Albert2009Zi/Power_Supply_Control_PIC12F675/01_Documents/On breadboard programming/PinoutBB2.jpg

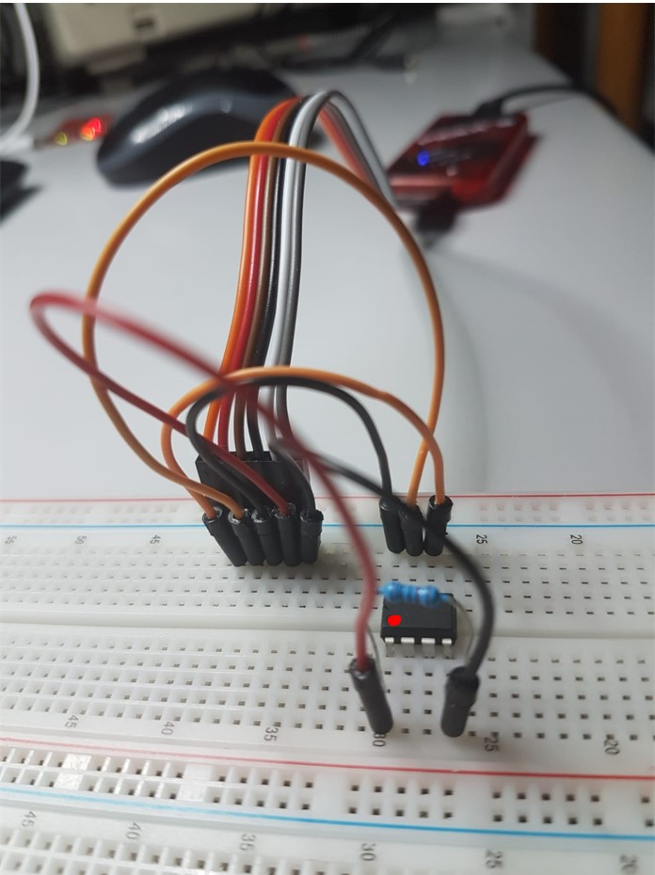
01_Documents/On breadboard programming/PinoutBB2.jpg
