Albert2009Zi/Power_Supply_Control_PIC12F675/01_Documents/Schematic1 Picture.jpg

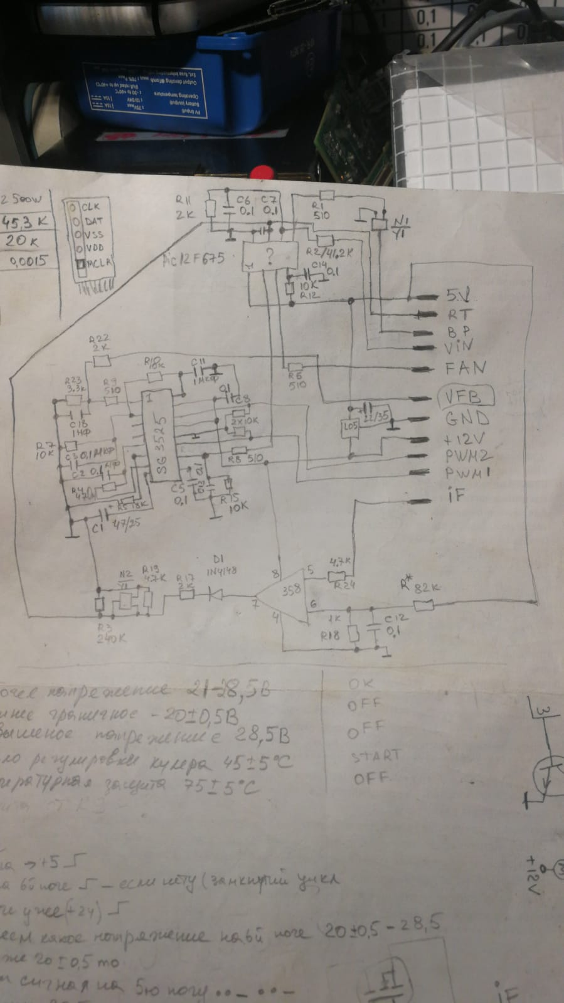
01_Documents/Schematic1 Picture.jpg
