Albert2009Zi/Power_Supply_Control_PIC12F675/04_Schematic/PIC12F675_prt_V2/Prototype.html

Altium customize

# Board Information Report

Date: | | 05.05.2024
Time: | | 17:31:00
Elapsed Time: | | 00:00:01
Filename: | | C:\dev\PCB Design\Altium\Projects\PIC12F675_prt\Prototype.PcbDoc
Units: | | mmmils

## Contents

Contents

Board Specification

General

Routing

Routing Information

Layer Information

Layer Information

Drill Pairs

Copper Area

Copper Area

Board Holes

Non-Plated Hole Size

Plated Hole Size

Board Slots

Non-Plated Slot Size

Plated Slot Size

Board Square Holes

Non-Plated Square Hole Size

Plated Square Hole Size

Other

Top Layer Annular Ring Size

Mid Layer Annular Ring Size

Bottom Layer Annular Ring Size

Pad Solder Mask

Pad Paste Mask

Pad Pwr/Gnd Expansion

Pad Relief Conductor Width

Pad Relief Air Gap

Pad Relief Entries

Via Solder Mask

Via Pwr/Gnd Expansion

Track Width

Arc Line Width

Arc Radius

Arc Degrees

Text Height

Text Width

Net Track Width

Net Via Size

## Board Specification

General
Board Size | 52.5mm x 57.5mm
Components on board | 31

Back to top

## Routing

Routing Information
Routing completion | 94,83%
Connections | 58
Connections routed | 55
Connections remaining | 3

Back to top

## Layer Information

Layer | Arcs | Pads | Vias | Tracks | Texts | Fills | Regions | ComponentBodies
Top Layer | 0 | 60 | 0 | 152 | 0 | 0 | 0 | 0
Bottom Layer | 0 | 3 | 0 | 17 | 0 | 0 | 1 | 0
Mechanical 1 | 0 | 0 | 0 | 1 | 0 | 0 | 0 | 30
Mechanical 13 | 3 | 0 | 0 | 129 | 0 | 0 | 0 | 1
Mechanical 15 | 0 | 0 | 0 | 122 | 0 | 0 | 0 | 0
Multi-Layer | 0 | 19 | 22 | 0 | 0 | 0 | 1 | 0
Top Paste | 0 | 0 | 0 | 0 | 0 | 0 | 0 | 0
Top Overlay | 24 | 0 | 0 | 57 | 60 | 0 | 0 | 0
Top Solder | 0 | 0 | 0 | 0 | 0 | 0 | 0 | 0
Bottom Solder | 0 | 0 | 0 | 0 | 0 | 0 | 0 | 0
Bottom Overlay | 2 | 0 | 0 | 4 | 2 | 0 | 0 | 0
Bottom Paste | 0 | 0 | 0 | 0 | 0 | 0 | 0 | 0
Drill Guide | 0 | 0 | 0 | 0 | 0 | 0 | 0 | 0
Keep-Out Layer | 0 | 0 | 0 | 0 | 0 | 0 | 0 | 0
Drill Drawing | 0 | 0 | 0 | 0 | 0 | 0 | 0 | 0
Total | 29 | 82 | 22 | 482 | 62 | 0 | 2 | 31

Back to top

Drill Pairs | Vias
Top Layer - Bottom Layer | 22
Total | 22

Back to top

## Copper Area

Layer | Sq.In. | Sq.MM. | Percent of layer
Top Layer | 0,512 | 330,623 | 11%
Bottom Layer | 4,516 | 2913,522 | 97%
Total | NaN | NaN

Back to top

## Board Holes

Non-Plated Hole Size | Pads | Vias
0mm | 63 | 0
1.2mm | 2 | 0
Total | 65 | 0

Back to top

Plated Hole Size | Pads | Vias
0.7mm | 2 | 0
0.7112mm | 0 | 22
0.9mm | 8 | 0
1.1mm | 2 | 0
1.15mm | 5 | 0
Total | 17 | 22

Back to top

## Board Slots

Non-Plated Slot Size / Length | Pads
Total | 0

Back to top

Plated Slot Size / Length | Pads
Total | 0

Back to top

## Board Square Holes

Non-Plated Square Hole Size | Pads
Total | 0

Back to top

Plated Square Hole Size | Pads
Total | 0

Back to top

## Other

Top Layer Annular Ring Size | Count
-0.6mm | 2
0.5mm | 2
0.55mm | 2
0.5588mm | 22
0.575mm | 5
0.6mm | 8
Total | 41

Back to top

Mid Layer Annular Ring Size | Count
-0.6mm | 2
0.5mm | 2
0.55mm | 2
0.5588mm | 22
0.575mm | 5
0.6mm | 8
Total | 41

Back to top

Bottom Layer Annular Ring Size | Count
-0.6mm | 2
0.5mm | 2
0.55mm | 2
0.5588mm | 22
0.575mm | 5
0.6mm | 8
Total | 41

Back to top

Pad Solder Mask | Count
0.1016mm | 82
Total | 82

Back to top

Pad Paste Mask | Count
0mm | 82
Total | 82

Back to top

Pad Pwr/Gnd Expansion | Count
0.508mm | 82
Total | 82

Back to top

Pad Relief Conductor Width | Count
0.254mm | 82
Total | 82

Back to top

Pad Relief Air Gap | Count
0.254mm | 82
Total | 82

Back to top

Pad Relief Entries | Count
4 | 82
Total | 82

Back to top

Via Solder Mask | Count
0.1016mm | 22
Total | 22

Back to top

Via Pwr/Gnd Expansion | Count
0.508mm | 22
Total | 22

Back to top

Track Width | Count
0.05mm | 84
0.1mm | 155
0.2mm | 65
0.254mm | 86
0.8mm | 92
Total | 482

Back to top

Arc Line Width | Count
0.0861mm | 2
0.1mm | 13
0.2mm | 12
0.25mm | 1
0.6mm | 1
Total | 29

Back to top

Arc Radius | Count
0.043mm | 2
0.05mm | 19
0.125mm | 1
0.3mm | 1
0.5mm | 1
0.635mm | 1
6.3mm | 4
Total | 29

Back to top

Arc Degrees | Count
180 | 26
360 | 3
Total | 29

Back to top

Text Height | Count
1.524mm | 62
Total | 62

Back to top

Text Width | Count
0.254mm | 62
Total | 62

Back to top

Net Track Width | Count
0.1mm | 17
Total | 17

Back to top

Net Via Size | Count
1.27mm | 17
Total | 17

Back to top
