Albert2009Zi/Power_Supply_Control_PIC12F675/01_Documents/On breadboard programming/Readme.txt

EN: This short photo guide is for my friend and co-author of this project, Alex Talko,
    who is working remotely on the hardware part.
    The guide shows how to connect and prepare the PIC12F625 microcontroller for programming
    using a Chinese clone of the PICkit3 debugger on a breadboard.
DE: Diese kurze Fotoanleitung ist für meinen Freund und Co-Autor dieses Projekts, Alex Talko, gemacht.
    Er arbeitet an diesem Projekt remote an der Hardware.
    Die Anleitung zeigt die Verbindung und Vorbereitung des PIC12F625-Mikrocontrollers zum Programmieren
    mit einem chinesischen Klon des PICkit3-Debuggers auf einer Lochrasterplatine.
