Albert2009Zi/Power_Supply_Control_PIC12F675/01_Documents/IMG-20221229-WA0002.jpg

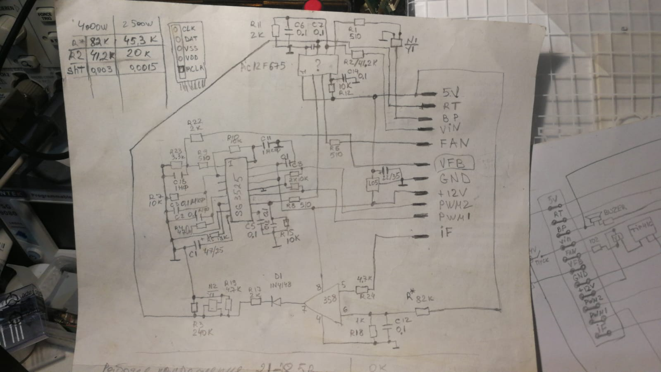
01_Documents/IMG-20221229-WA0002.jpg
