Albert2009Zi/Power_Supply_Control_PIC12F675/01_Documents/IMG-20230827-WA0010.jpg

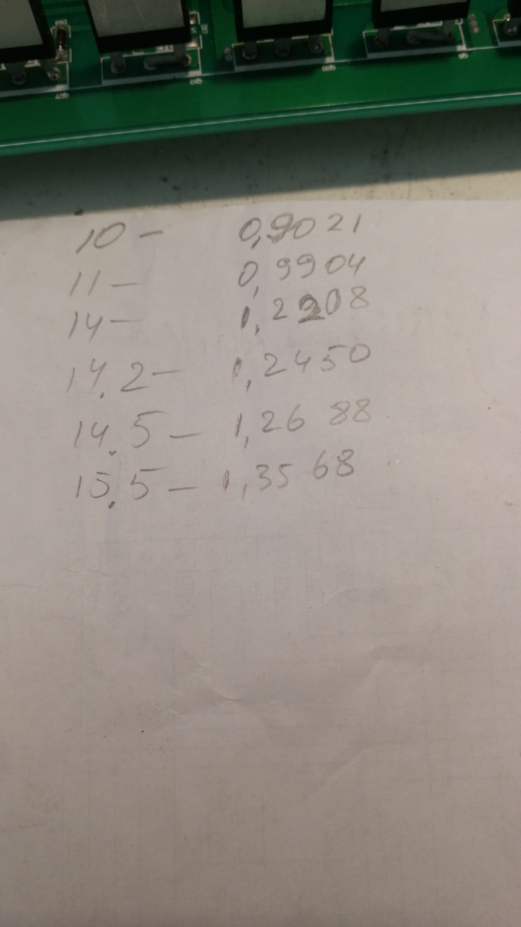
01_Documents/IMG-20230827-WA0010.jpg
