Albert2009Zi/Power_Supply_Control_PIC12F675/01_Documents/On breadboard programming/Schematic.png

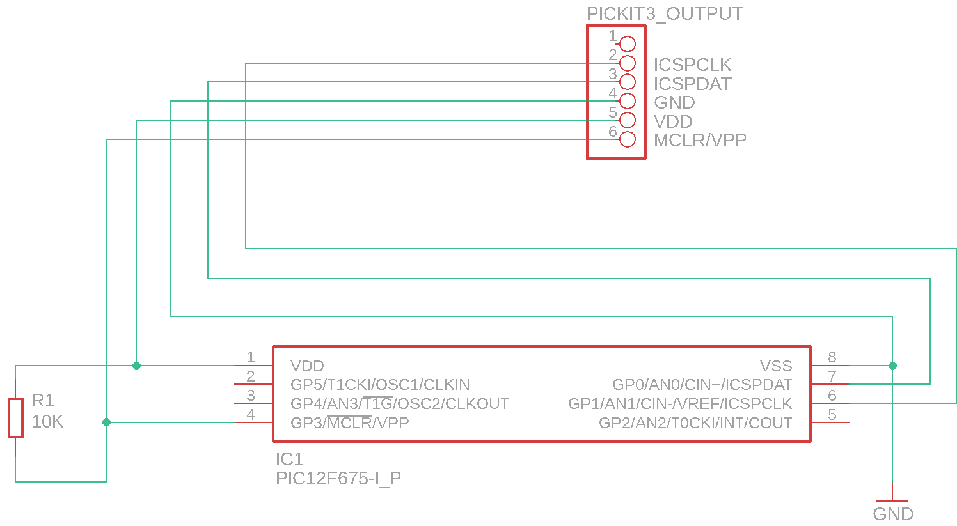
01_Documents/On breadboard programming/Schematic.png
