Albert2009Zi/Power_Supply_Control_PIC12F675/01_Documents/On breadboard programming/WhatsApp Image 2022-04-28 at 20.59.34 (2).jpeg

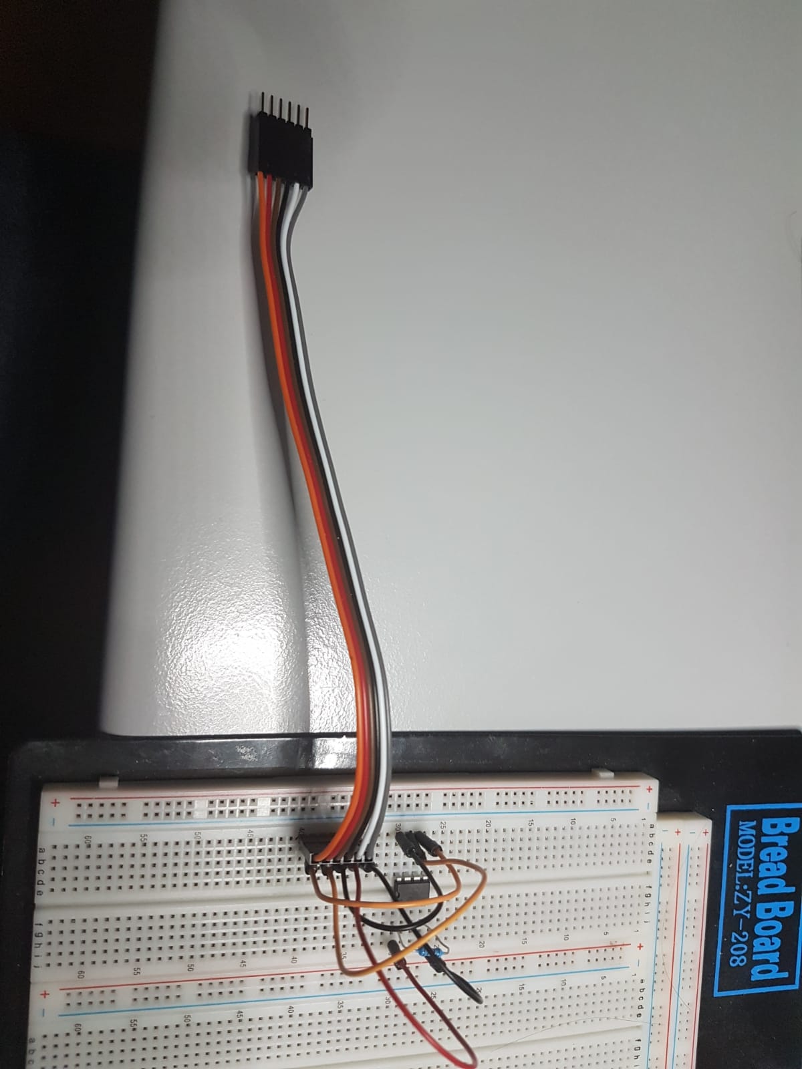
01_Documents/On breadboard programming/WhatsApp Image 2022-04-28 at 20.59.34 (2).jpeg
