Albert2009Zi/Power_Supply_Control_PIC12F675/01_Documents/Real Config TalkoS.png

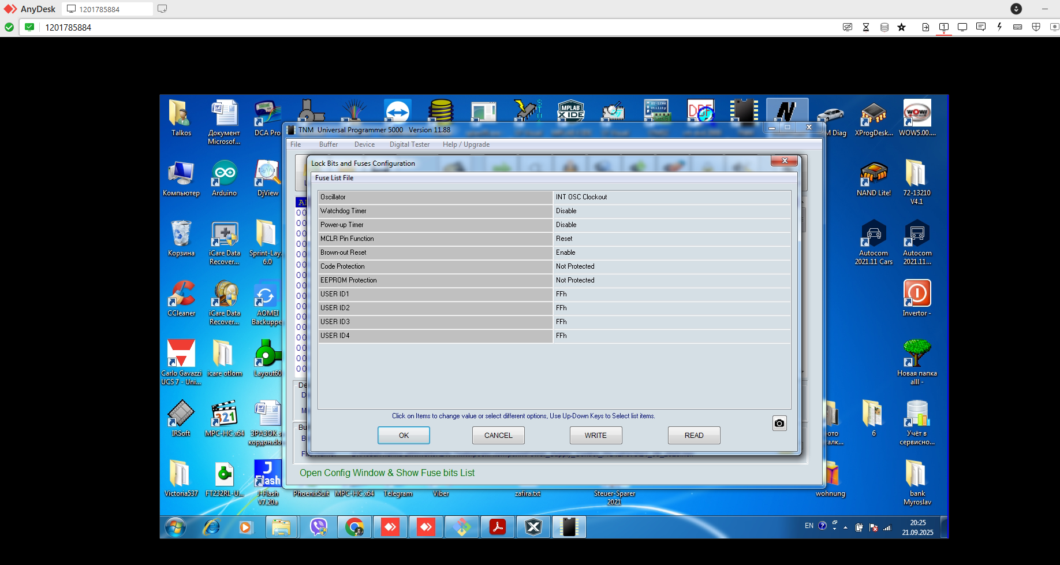
01_Documents/Real Config TalkoS.png
