Albert2009Zi/Power_Supply_Control_PIC12F675/01_Documents/загрузка (1).png

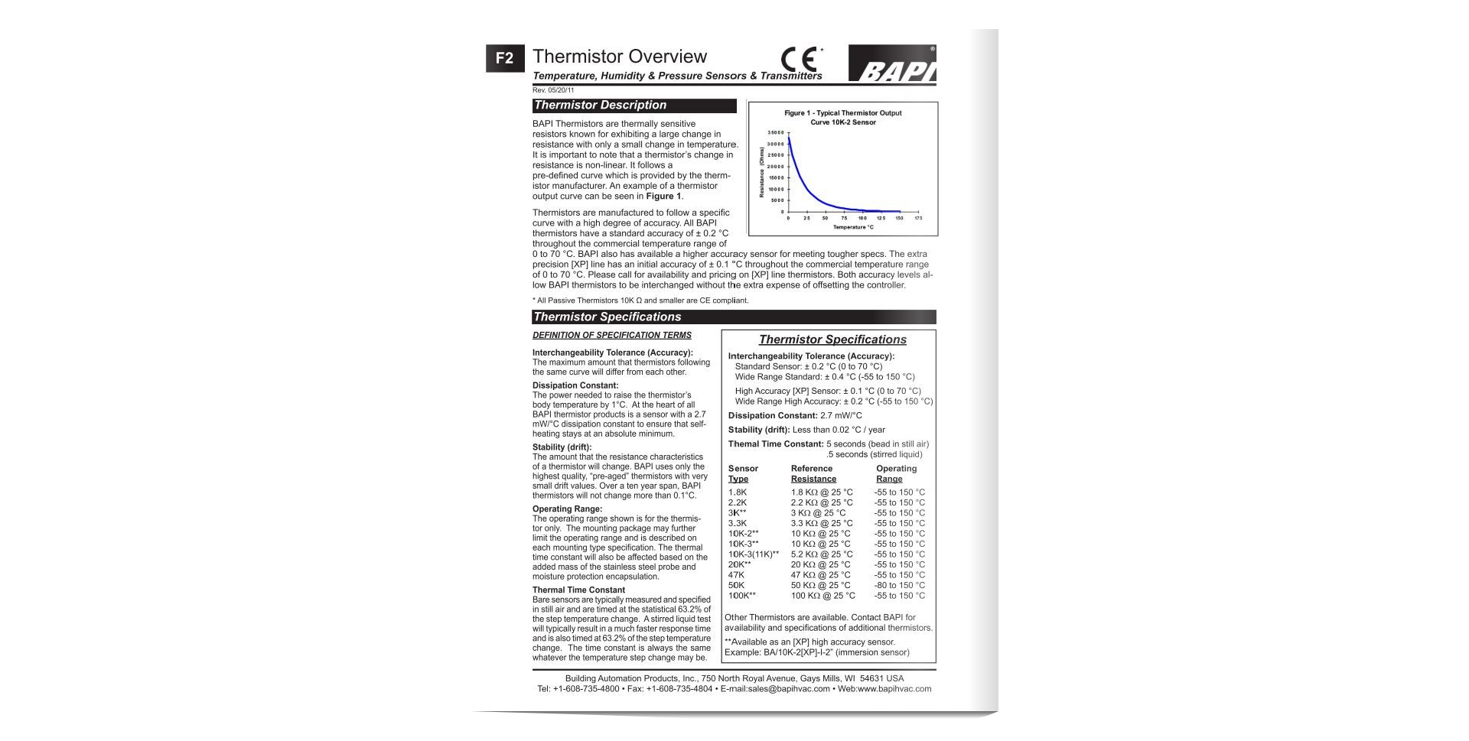
01_Documents/загрузка (1).png
