Albert2009Zi/Power_Supply_Control_PIC12F675/01_Documents/изображение_viber_2021-11-18_21-27-20.jpg

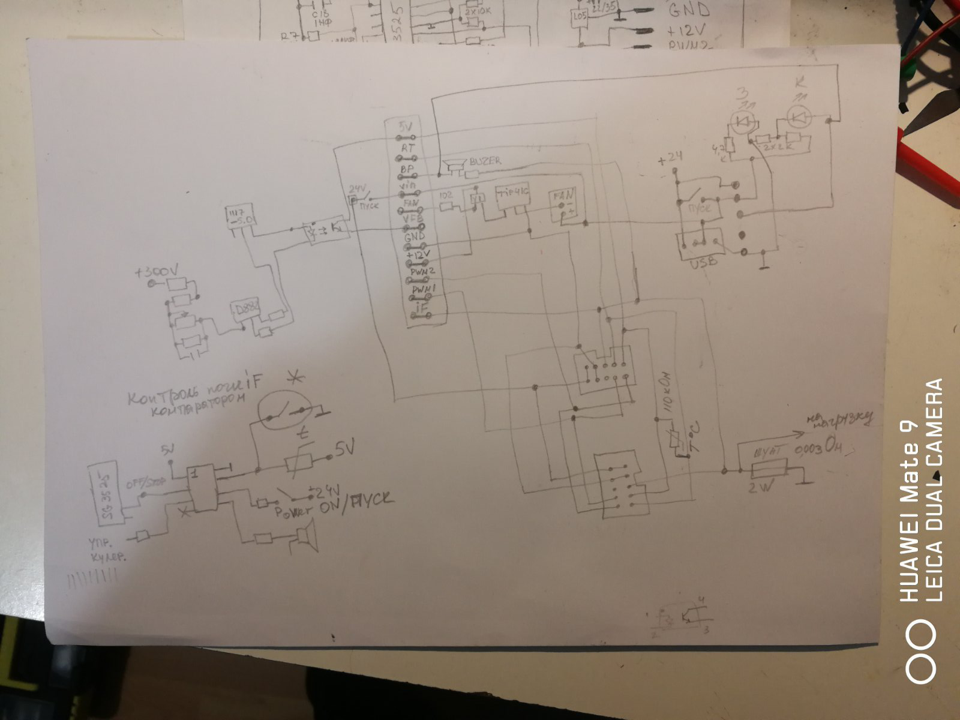
01_Documents/изображение_viber_2021-11-18_21-27-20.jpg
