Albert2009Zi/Power_Supply_Control_PIC12F675/01_Documents/изображение_viber_2022-04-18_20-02-22-770.jpg

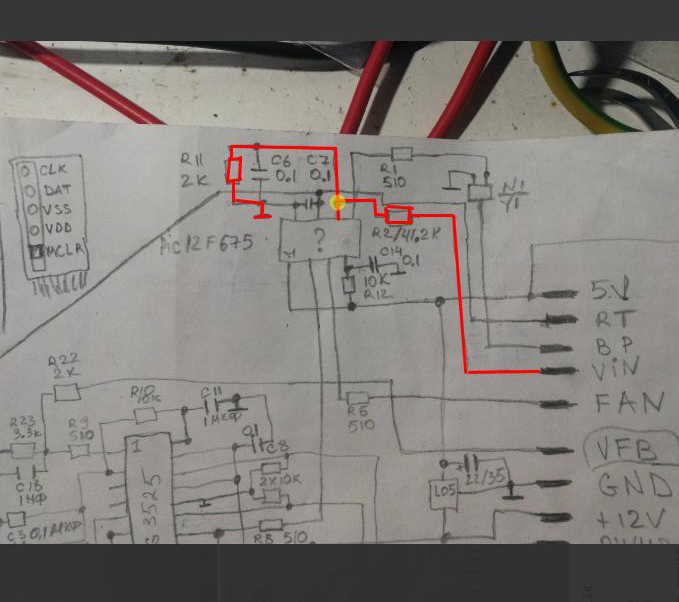
01_Documents/изображение_viber_2022-04-18_20-02-22-770.jpg
