Albert2009Zi/Power_Supply_Control_PIC12F675/04_Schematic/FilterDesiganator.png

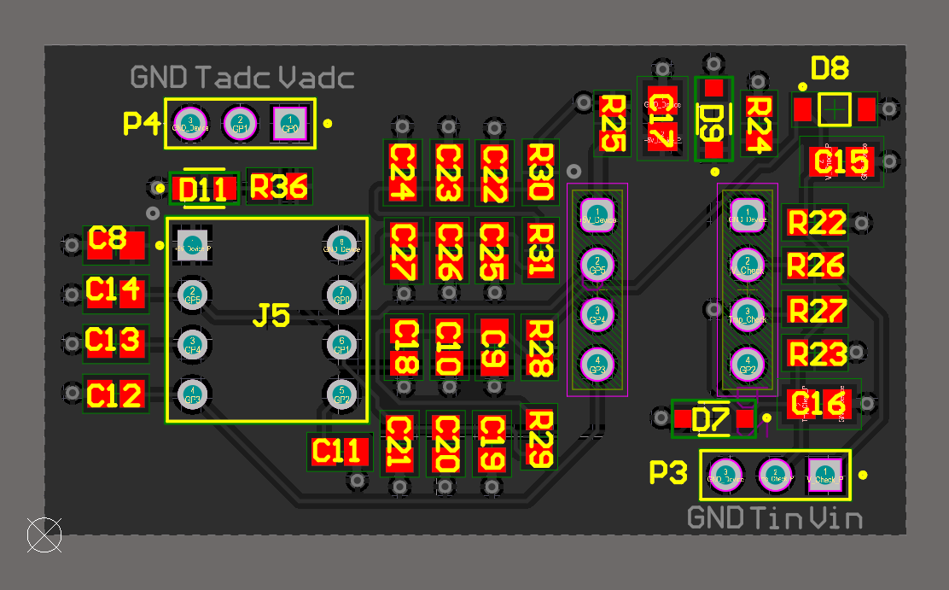
04_Schematic/FilterDesiganator.png
