Albert2009Zi/Power_Supply_Control_PIC12F675/04_Schematic/PIC12F675_prt_V2/Project Outputs for PIC12F675_prt_V2/PIC12F675_prt_V2.xlsx

Comment | Description | Designator | Footprint | LibRef | Quantity
22uF/25V | Capacitor Polarised | C1 | CAPAE530X610N | APXG250ARA220ME61G | 1
1uF/25V | Capacitor | C2 | CAPC2012X70N | GRM216F51E104ZA01D | 1
1uF/50V | Capacitor Polarised | C3 | CAPAE430X550N | 865060640001 | 1
100uF/25V | Capacitor Polarised | C4 | CAPAE660X770N | 865090445008 | 1
0.1uF/25V | Capacitor | C5 | CAPC2012X70N | GRM216F51E104ZA01D | 1
680nF/25V | Capacitor | C6, C7 | CAPC2012X95N | GRM219B31E684KA88D | 2
100nF/50V |  | C8, C11, C12, C13, C14 | CAPC2013X145X48NL20T23 | CMP-2007-03167-1 | 5
10uF/16V |  | C9, C19, C22, C25 | CAPC2013X145X48NL20T23 | CMP-2007-03167-1 | 4
1uF/16V |  | C10, C20, C23, C26 | CAPC2013X145X48NL20T23 | CMP-2007-03167-1 | 4
1nF |  | C15, C16, C17 | CAPC2013X145X48ML20T23 | CMP-2007-03154-1 | 3
100nF/16V |  | C18, C21, C24, C27 | CAPC2013X145X48NL20T23 | CMP-2007-03167-1 | 4
MRA4007T3G | Diode | D1 | DIOM5226X220N | MRA4007T3G | 1
LGR971 | LED GREEN DIFFUSED 0805 SMD | D2, D4, D6 | FP-LG_R971-MFG | CMP-62016-000039-1 | 3
1N4007 | Diode | D3 | DIOM5027X244N | 1n4007-SMD | 1
LS R976-NR-1 | LED RED DIFFUSED 0805 SMD | D5 | FP-LS_R976-MFG | CMP-62016-000037-1 | 1
BZT52C5V1-7-F | DIODE ZENER 5.1V 500MW SOD123 | D7, D9 | FP-SOD123-MFG | CMP-2000-05976-2 | 2
MMSZ4678T1G | Zener Voltage Regulator, 500 mW, 2-Pin SOD-123, Pb-Free, Tape and Reel | D8 | ONSC-SOD-123-2-425-04_V | CMP-1060-00511-1 | 1
Device ON | LED RED DIFFUSED 0805 SMD | D11 | FP-LS_R976-MFG | CMP-62016-000037-1 | 1
LM7805 | Integrated Circuit | IC1 | SOT230P700X180-4N | LM7805MPX_NOPB | 1
1752214 | Connector | J1 | 1752214 | 1752214 | 1
5-146281-5 | Connector | J2 | HDRV5W67P0X254_1X5_1229X234X821P | 5-146281-5 | 1
1-2199298-2 | CONN IC DIP SOCKET 8POS TIN | J5 | FP-1-2199298-2-MFG | CMP-03370-000009-1 | 1
TMB12A05 | Loudspeaker or Buzzer | LS1 | TMB12A05 | TMB12A05 | 1
61300411121 |  | P1, P2 | 61300411121 | CMP-1502-01064-3 | 2
22-28-4033 | Male Header, Pitch 2.54 mm, 1 x 3 Position, Height 8.38 mm, Tail Length 3.18 mm, RoHS, Bulk | P3, P4 | MOLX-22-28-4033_V | CMP-1676-00001-5 | 2
TP0610K-T1-E3 | MOSFET P-CH 60V 185MA SOT23-3 | Q1, Q2 | FP-S-03946-MFG | CMP-02550-000129-1 | 2
BC847 | Transistor BJT NPN | Q3, Q4 | BC847215 | BC847,215 | 2
BC856 | PNP General Purpose Transistor, 65 V, -65 to 150 degC, 3-Pin SOT23, RoHS | Q5 | NXP-SOT23-3_V | CMP-2000-05936-1 | 1
0R |  | R1 | RESC2013X55X40NL15T20 | CMP-2001-04755-1 | 1
1K2 |  | R2 | RESC2013X55X40NL15T20 | CMP-2001-04755-1 | 1
360R |  | R3, R36 | RESC2013X55X40NL15T20 | CMP-2001-04755-1 | 2
100R | Resistor | R4 | RESC2012X60N | CRCW0805100RFKEAHP | 1
41K2 | Resistor | R5 | RESC2012X65N | CPF0805B41K2E1 | 1
220R | Resistor | R6, R13, R16 | RESC2012X65N | CPF0805B220RE | 3
2K | Resistor | R7 | RESC2012X65N | CPF0805B360RE1 | 1
100K | Resistor | R8, R11 | RESC2012X65N | CPF0805B360RE1 | 2
10K | Resistor | R9, R10, R12, R14, R15, R17 | RESC2012X65N | CPF0805B360RE1, CPF0805B220RE | 6
360R | Resistor | R18, R19 | RESC2012X65N | CPF0805B360RE1 | 2
4K7 | Resistor | R20, R21 | RESC2012X65N | CPF0805B360RE1 | 2
2K |  | R22, R23, R24 | RESC2013X55X40NL15T20 | CMP-2001-04755-1 | 3
1K |  | R25, R26, R27 | RESC2013X55X40NL15T20 | CMP-2001-04755-1 | 3
22K |  | R28, R29, R30, R31 | RESC2013X55X40NL15T20 | CMP-2001-04755-1 | 4
PIC12F675 | FLASH-Based 8-Bit CMOS Microcontroller, 10-Bit A/D, 8-Pin PDIP, Industrial Temperature | U1 | PDIP300-P8 | CMP-0190-00021-1 | 1
1K | Variable Resistor | VR1 | 23SR1KLFTR | 23SR1KLFTR | 1
