Albert2009Zi/Power_Supply_Control_PIC12F675/01_Documents/Measurements/Measurmnets25082024.xlsx

Vin | Vpin6 | Wert | 1pkt = 0.0049
10.2 | 0.44 | 89
15 | 0.66 | 135
By Alex 26082024
10.2 | 0.2656
11.2 | 0.3036 |  | 1V = 0,038
14.5 | 0.4046
15.5 | 0.4426
By Albert on Evaluation Board v2 |  | Real work parameter
10.0 | 0.4830 | 96
12.0 | 0.5765 | 116
15.5 | 0.7350 | 148
