Albert2009Zi/Power_Supply_Control_PIC12F675/01_Documents/Measurements/Temperature measurements.xlsx

Temperature, C◦ | ADC Voltage, V | ADRES Value, Digits | Volts per Digits: 1V = 0,00488 Vref = 5V
20 | 3.4 | 696
22 | 3.5 | 716
26 | 3.6 | 736
28 | 3.8 | 778
32 | 4.0 | 819
35 | 4.1 | 840
38 | 4.2 | 860
42 | 4.3 | 881
46 | 4.4 | 901
54 | 4.5 | 922
65 | 4.6 | 942
72 | 4.7 | 963
78 | 4.8 | 983
