Albert2009Zi/Power_Supply_Control_PIC12F675/01_Documents/Measurements/загрузка.png

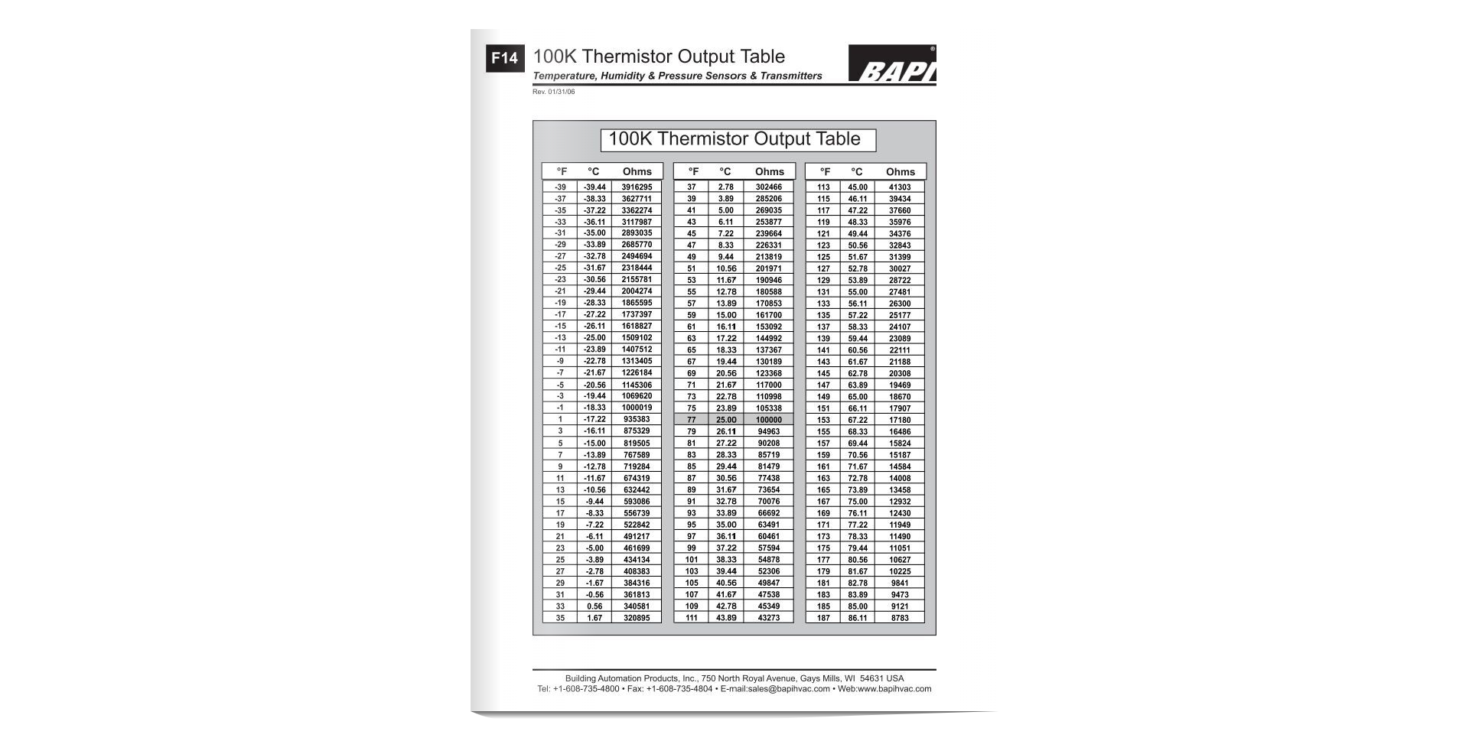
01_Documents/Measurements/загрузка.png
