Albert2009Zi/Power_Supply_Control_PIC12F675/04_Schematic/PDF/Filter.pdf

Entry Socket | Entry Signals Protection

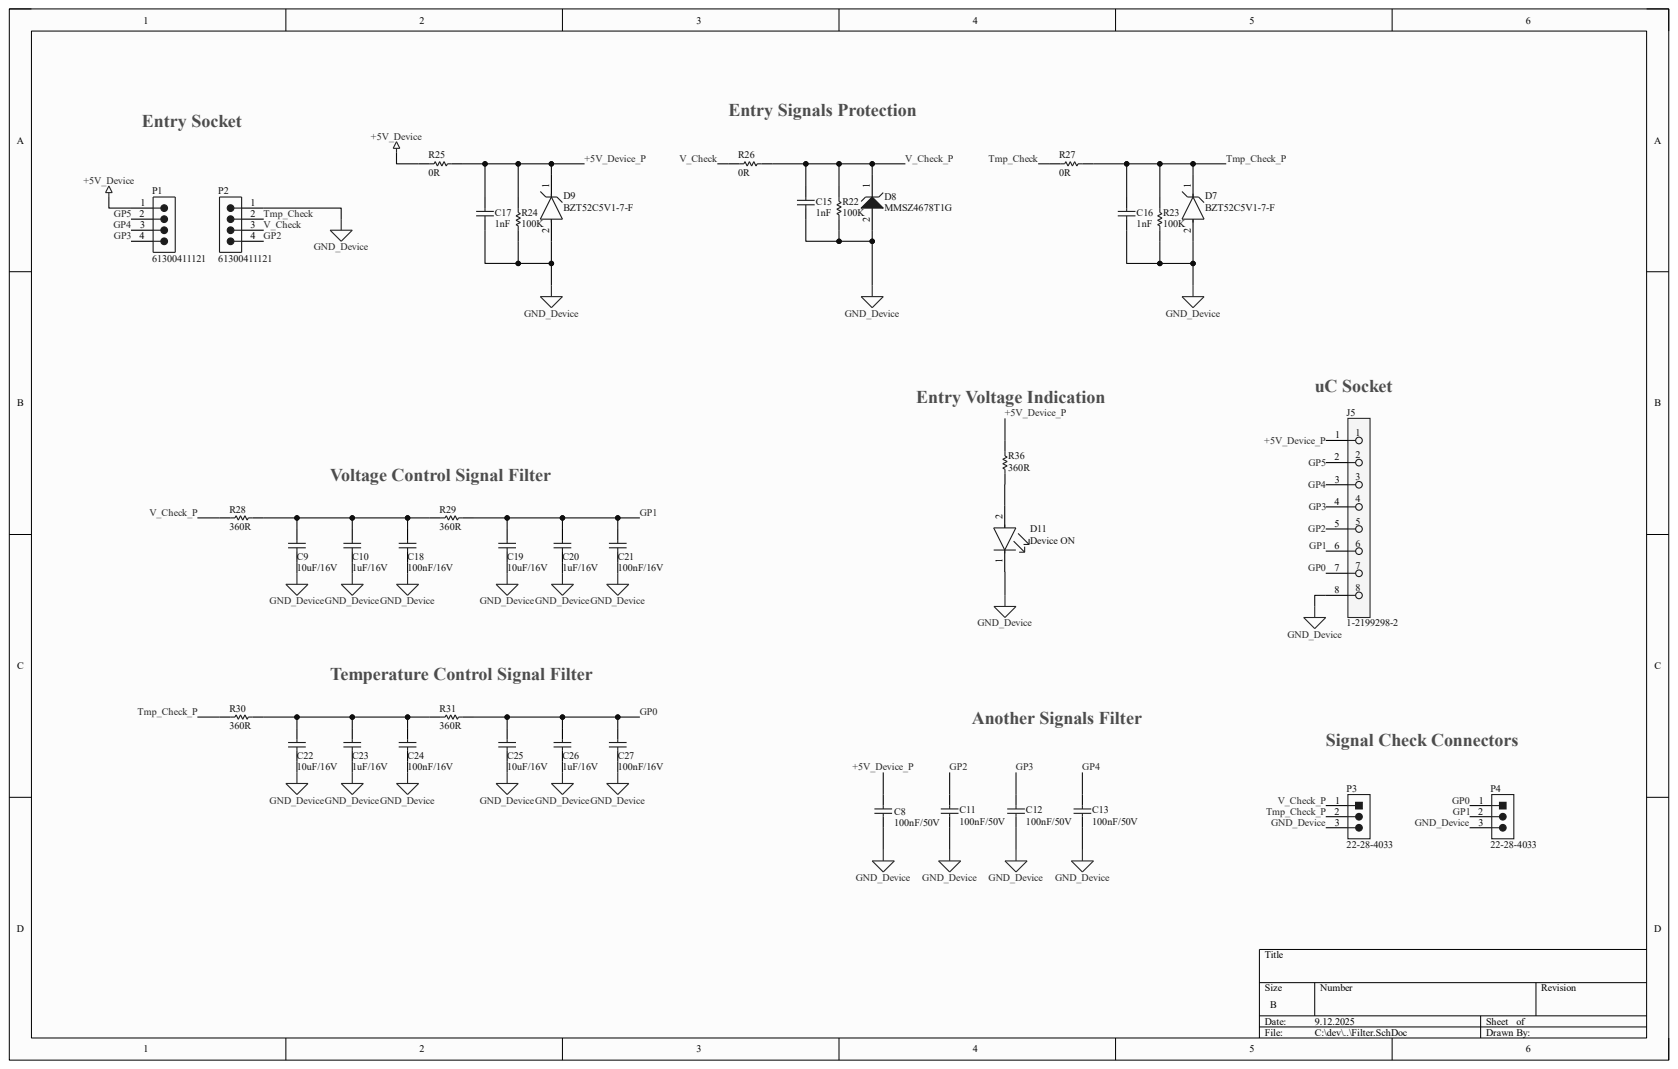
[picture p27: page 1]

Voltage Control Signal Filter

Temperature Control Signal Filter
