Albert2009Zi/Power_Supply_Control_PIC12F675/04_Schematic/PDF/Power.pdf

# +Vin Source

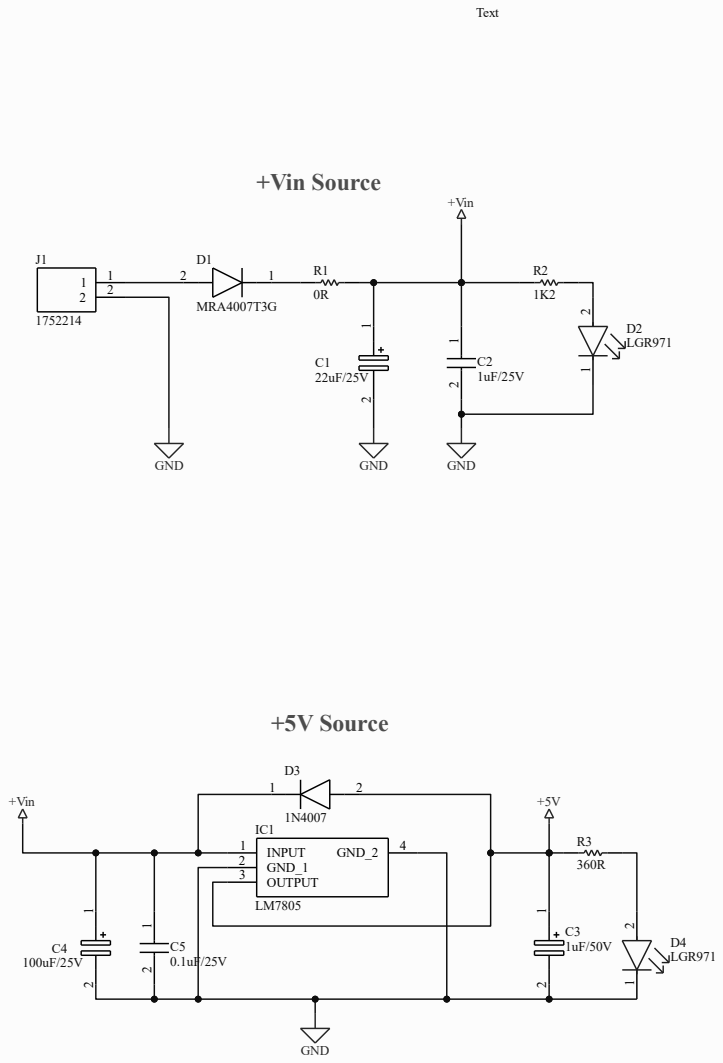
[picture p28: page 1]
