Albert2009Zi/Power_Supply_Control_PIC12F675/04_Schematic/PDF/uC.pdf

# Alarms Sound

# Measuring for functionality check

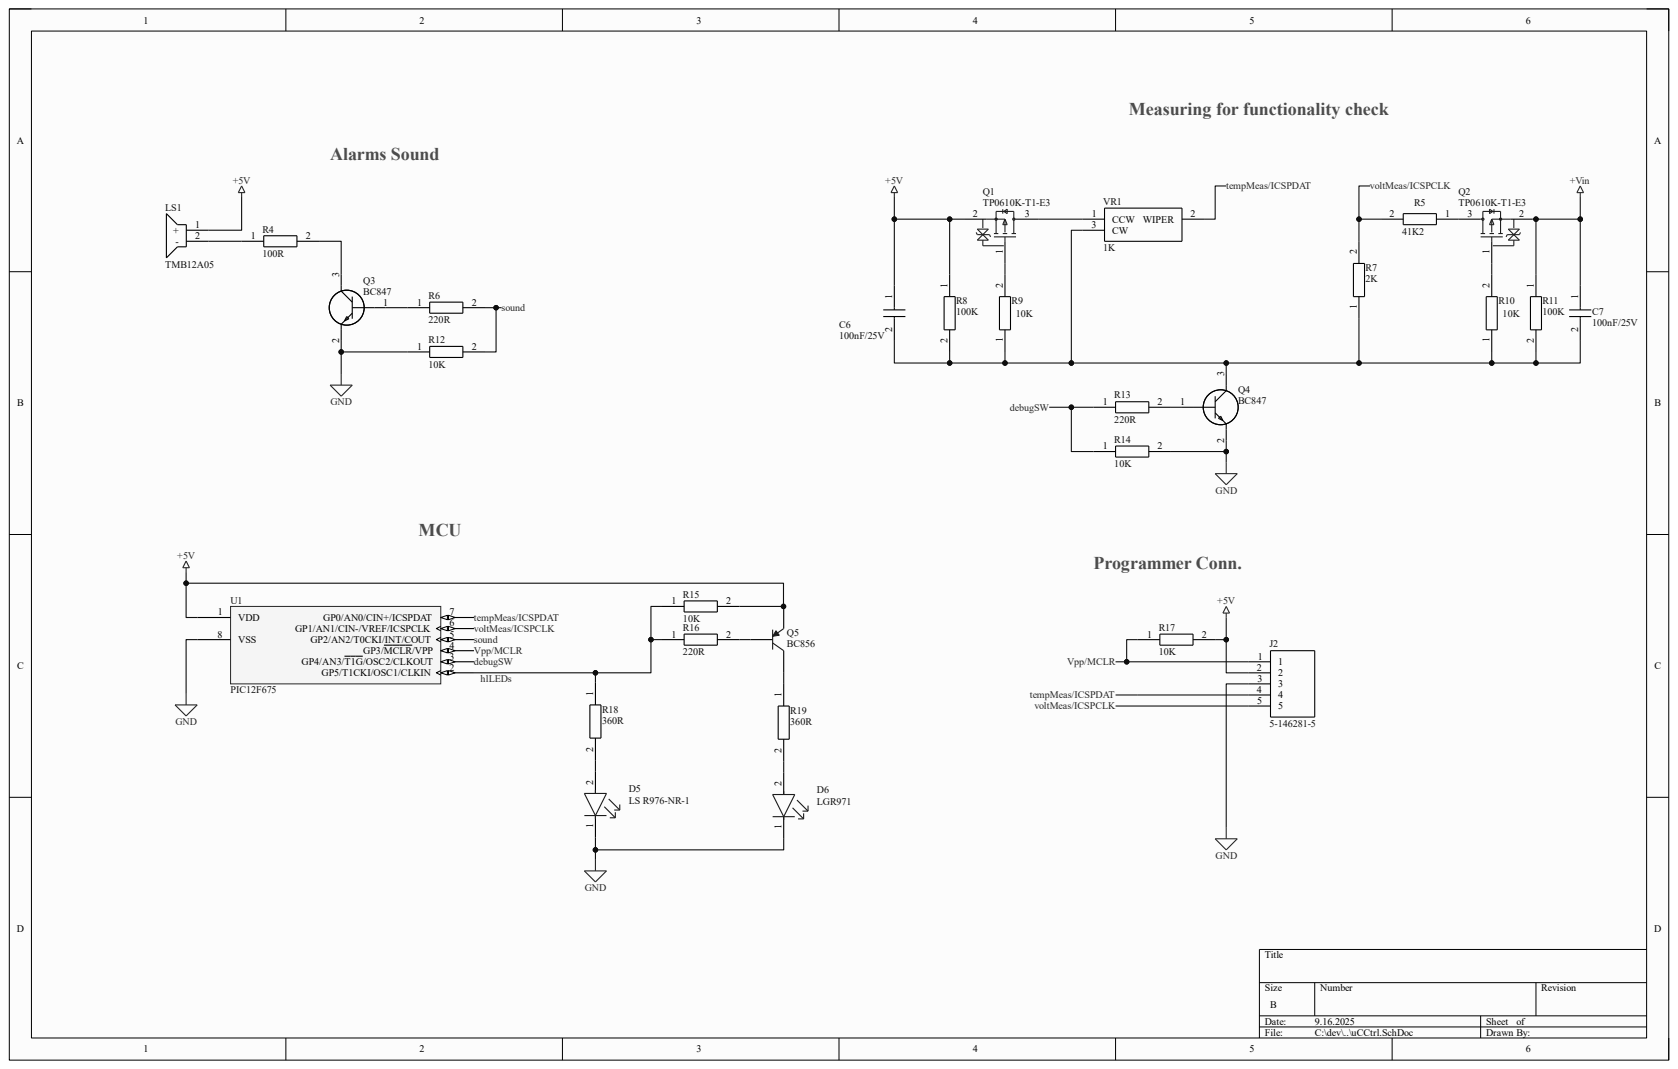
[picture p29: page 1]
