Albert2009Zi/Power_Supply_Control_PIC12F675/02_Simulation/LT-Spice/Draft1.asc

D1: diode; 1N4007
D2: zener; UMZ5_1N
R1: res; 100k
R2: res; 1k
V1: voltage; 16
Named nets: 0
.tran 1
