Albert2009Zi/Power_Supply_Control_PIC12F675/02_Simulation/LT-Spice/OA_Filter.asc

B1: bv; V=WHITE(1000*time)
C1: cap; 1µ
C2: cap; 1µ
C3: cap; 10µ; V=25
C4: cap; 10µ
C5: cap; 100n
C6: cap; 100n
R1: res; 22k
R4: res; 22K
R5: res; 2K
R6: res; 41K2
V3: voltage; 12
Named nets: 0, Vin, Vout
.tran 1
