Albert2009Zi/Power_Supply_Control_PIC12F675/02_Simulation/LT-Spice/Zener.asc

C1: cap; 1n
D1: diode; 1N4007
D2: zener; UMZ5_1N
R1: res; 100k
R2: res; 1K
R3: res; 2K
V1: voltage; 16
Named nets: 0
.tran 1
