Albert2009Zi/Power_Supply_Control_PIC12F675/(list of files, drawings)

Other design files:
02_Simulation/BusSwitch.pdsprj
02_Simulation/Filter_Simulation.pdsprj
02_Simulation/Project Backups/BusSwitch [20240616, 17-19-15].pdsprj
02_Simulation/Project Backups/Filter_Simulation [20250426, 20-35-37].pdsprj
02_Simulation/Project Backups/Filter_Simulation [20250426, 20-41-18].pdsprj
02_Simulation/Project Backups/Filter_Simulation [20250426, 21-14-49].pdsprj
02_Simulation/Project Backups/Filter_Simulation [20250427, 21-44-36].pdsprj
02_Simulation/Project Backups/Simulation [20250820, 20-35-27].pdsprj
02_Simulation/Project Backups/Simulation [20250820, 20-35-35].pdsprj
02_Simulation/Project Backups/Simulation [20250820, 20-36-00].pdsprj
02_Simulation/Project Backups/Simulation [20250820, 20-36-20].pdsprj
02_Simulation/Project Backups/Simulation [20250820, 20-36-49].pdsprj
02_Simulation/Project Backups/Simulation [20250820, 20-37-57].pdsprj
02_Simulation/Project Backups/Simulation [20250820, 20-38-33].pdsprj
02_Simulation/Project Backups/Simulation [20250820, 21-05-02].pdsprj
02_Simulation/Project Backups/Simulation [20250820, 21-05-25].pdsprj
02_Simulation/Project Backups/Simulation [20250820, 21-05-47].pdsprj
02_Simulation/Project Backups/Simulation [Proteus 8.7].pdsprj
02_Simulation/Project Backups/Simulation R01 [20231108, 21-07-55].pdsprj
02_Simulation/Project Backups/Simulation R01 [20231108, 21-09-41].pdsprj
02_Simulation/Project Backups/Simulation R01 [20231108, 21-11-17].pdsprj
02_Simulation/Project Backups/Simulation R01 [20231108, 21-12-00].pdsprj
02_Simulation/Project Backups/Simulation R01 [20231108, 21-12-14].pdsprj
02_Simulation/Project Backups/Simulation R01 [20231108, 21-14-46].pdsprj
02_Simulation/Project Backups/Simulation R01 [20231108, 21-15-12].pdsprj
02_Simulation/Project Backups/Simulation R01 [20231108, 21-15-13].pdsprj
02_Simulation/Project Backups/Simulation R01 [20231108, 21-16-30].pdsprj
02_Simulation/Project Backups/Simulation R01 [20231108, 21-17-34].pdsprj
02_Simulation/Project Backups/Timer1 [20240219, 20-16-41].pdsprj
02_Simulation/Project Backups/Timer1 [20240219, 20-17-46].pdsprj
02_Simulation/Project Backups/Timer1 [20240219, 20-19-18].pdsprj
02_Simulation/Project Backups/Timer1 [20240219, 20-23-48].pdsprj
02_Simulation/Project Backups/Timer1 [20240219, 20-25-11].pdsprj
02_Simulation/Project Backups/Timer1 [20240219, 20-25-20].pdsprj
02_Simulation/Project Backups/Timer1 [20240219, 20-28-51].pdsprj
02_Simulation/Project Backups/Timer1 [20240219, 20-30-02].pdsprj
02_Simulation/Project Backups/Timer1 [20240219, 20-30-14].pdsprj
02_Simulation/Project Backups/Timer1 [20240219, 20-31-03].pdsprj
02_Simulation/Simulation R01.pdsprj
02_Simulation/Simulation.pdsprj
02_Simulation/Simulation_Coop/Project Backups/Simulation_Coop [20240903, 22-21-44].pdsprj
02_Simulation/Simulation_Coop/Project Backups/Simulation_Coop [20240903, 22-22-26].pdsprj
02_Simulation/Simulation_Coop/Project Backups/Simulation_Coop [20240909, 21-02-51].pdsprj
02_Simulation/Simulation_Coop/Project Backups/Simulation_Coop [20240909, 21-07-35].pdsprj
02_Simulation/Simulation_Coop/Project Backups/Simulation_Coop [20240909, 21-11-05].pdsprj
02_Simulation/Simulation_Coop/Project Backups/Simulation_Coop [20240909, 21-11-21].pdsprj
02_Simulation/Simulation_Coop/Project Backups/Simulation_Coop [20240909, 21-12-13].pdsprj
02_Simulation/Simulation_Coop/Project Backups/Simulation_Coop [20240909, 21-12-25].pdsprj
02_Simulation/Simulation_Coop/Project Backups/Simulation_Coop [20240909, 21-16-17].pdsprj
02_Simulation/Simulation_Coop/Project Backups/Simulation_Coop [20240909, 21-23-31].pdsprj
02_Simulation/Simulation_Coop/Simulation_Coop.pdsprj
02_Simulation/Timer1.pdsprj
04_Schematic/PIC12F675_prt_V1/Filter.SchDoc
04_Schematic/PIC12F675_prt_V1/measureSignals.SchDoc
04_Schematic/PIC12F675_prt_V1/PIC12F675_prt.PcbLib
04_Schematic/PIC12F675_prt_V1/PIC12F675_prt.PrjPcb
04_Schematic/PIC12F675_prt_V1/PIC12F675_prt.SCHLIB
04_Schematic/PIC12F675_prt_V1/power.SchDoc
04_Schematic/PIC12F675_prt_V1/ProtoGrids.PcbLib
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
