Albert2009Zi/Power_Supply_Control_PIC12F675/03_Software/Power_Supply_Control_PIC12F675.X/sounds.c

#include <xc.h>
#include "sounds.h"
#include "interrupt.h"
#include "initPeriphery.h"

#define _XTAL_FREQ   4000000

#define BEEPS_PER_ALERT 5

volatile uint16_t cnt0 = 0;


/*Sound parameters*/
typedef struct{
      uint16_t duration;
      uint8_t  allowTimeout; 
} SoundParameters;

/*Queue and its variables*/
SoundParameters beepsQueue[BEEPS_PER_ALERT];
uint8_t queueHead = 0;
uint8_t queueTail = 0;


void EnqueueBeeps(uint16_t duration, uint8_t allowTimeout) {
    
    if ((queueTail + 1) % BEEPS_PER_ALERT != queueHead) {
    
        beepsQueue[queueTail].duration     = duration;
        beepsQueue[queueTail].allowTimeout = allowTimeout;
        queueTail = (queueTail + 1) % BEEPS_PER_ALERT;
    } 
}



/*Playing of simple sound LONG = 200ms or SHORT = 120ms*/
void BeepsStateMachine(void){  

    static uint8_t  state                    = 0;
    static uint16_t stateMachineDuration     = 0;
    static uint8_t  stateMachineAllowTimeout = 0;

    switch(state){
       case 0:    
        if (queueHead != queueTail) {
                stateMachineDuration      = beepsQueue[queueHead].duration;
                stateMachineAllowTimeout  = beepsQueue[queueHead].allowTimeout;
                queueHead = (queueHead + 1) % BEEPS_PER_ALERT;
                GP2 = 1;   
                cnt0 = 0;
                state = 1;
		        prmFlags.alarmState = BUSY;
            }
	break;
	
        case 1:
	  if (cnt0 >= stateMachineDuration){
             cnt0  = 0;
             state = 2;
             GP2   = 0;
          } 
	break;
	
	case 2:
          if (cnt0 >= WAIT_TIME){ 
             cnt0  = 0; 
             if (stateMachineAllowTimeout == NO_TIMEOUT){ 
                 state = 0;    
	        }
            else if (stateMachineAllowTimeout == YES_TIMEOUT){
	        state = 3;
	        }
           }   
        break;
   
        case 3:
         if (cnt0 >= TIME_OUT){
           cnt0       = 0;
           queueHead  = 0;
           queueTail  = 0; 
	       state      = 0;	
	       prmFlags.alarmState = FREE; 
         }   
	break;
	 
        default:
        break;	
   }
}

/**/

void playAlert() {

   uint8_t howMuchTimesPlayShort = NONE; 
   uint8_t howMuchTimesPlayLong  = NONE;
   uint8_t totalBeeps            = NONE;
   static uint8_t soundState     = 0;
   
   switch (soundState){
     case 0:
      if (prmFlags.errorUnderVoltage){
        howMuchTimesPlayShort = TWO;
        howMuchTimesPlayLong  = ONE;
        } 	
      if (!prmFlags.alarmState) soundState = 1; 	
     break;
     
     case 1:  
     if (prmFlags.errorOverVoltage) {
         howMuchTimesPlayShort = TWO;
         howMuchTimesPlayLong  = TWO; 
	 }  
      if (!prmFlags.alarmState) soundState = 2;	 
     break;
    
     case 2:  
     if (prmFlags.errorHighTemperature){
       howMuchTimesPlayShort = THREE;
       howMuchTimesPlayLong  = NONE; 
       }   
      if (!prmFlags.alarmState) soundState = 3; 
     break; 
     
     case 3:
      if (prmFlags.playLong){
       howMuchTimesPlayShort = NONE;
       howMuchTimesPlayLong  = ONE; 
       }   
      if (!prmFlags.alarmState) {
       soundState = 0; 
       prmFlags.playLong = 0;
       }
     break; 
     
     default:
     break;
}
           
    totalBeeps = howMuchTimesPlayShort + howMuchTimesPlayLong;
    
    // Add short beeps
    for (uint8_t i = 0; i < howMuchTimesPlayShort; i++) {
        if (i == (totalBeeps - 1)) {
            EnqueueBeeps(SHORT, YES_TIMEOUT);  // last
        } else {
            EnqueueBeeps(SHORT, NO_TIMEOUT);
        }
    }

    //  Add long beeps
    for (uint8_t i = 0; i < howMuchTimesPlayLong; i++) {
        if ((howMuchTimesPlayShort + i) == totalBeeps - 1) {
            EnqueueBeeps(LONG, YES_TIMEOUT);  // last
        } else {
            EnqueueBeeps(LONG, NO_TIMEOUT);
        }
    }
}
