Albert2009Zi/Power_Supply_Control_PIC12F675/03_Software/Power_Supply_Control_PIC12F675.X/initPeriphery.h

/* 
 * File:   init_periphery.h
 * Author: User
 *
 * Created on 5 ????? 2022 ?., 12:35
 */

#ifndef INIT_PERIPHERY_H
#define	INIT_PERIPHERY_H

void InitTimer0(void);

void Init_uC(void);

#endif	/* INIT_PERIPHERY_H */
