Albert2009Zi/Power_Supply_Control_PIC12F675/(commit log)

2021-12-11 First project alfa prototype. Have a lot of bugs and problems
    [Configuration.h, Cooler_Control_Simulation.pdsprj]
2022-03-06 First work release. Temperature Control not works
    [Cooler_Control_Simulation.pdsprj, Player.obj, Simulation.pdsprj, startup.obj]
2022-03-06 Second work release. Temperature Control not works
    [Simulation.pdsprj]
2022-03-08 Second Release. Simple. Without PWM.
2022-03-08 Third Release. Simple. Without PWM. Cooler ON in main.c
2022-03-14 PWM and Button together. Must make Thermo Algorithm.
    [Simulation.pdsprj]
2022-03-15 Thermo control works. Without sounds and over/low voltage control
    [Simulation.pdsprj]
2022-04-10 Bug with Cooler start fixed
    [Simulation.pdsprj]
2022-04-28 PWM good
2022-12-30 intermediate result 30122022 - first realisation of over and under voltage on pin 6
2023-01-10 Pin7 and Pin6 Control enabled
    [Player.obj, Simulation.pdsprj, startup.obj]
2023-01-19 Temperature and Voltage control works correct
    [Simulation [20230115, 19-45-01].pdsprj, Simulation [20230115, 19-45-23].pdsprj, Simulation [20230115, 19-48-05].pdsprj, Simulation [20230115, 19-49-01].pdsprj, Simulation [20230115, 19-49-02].pdsprj, Simulation [20230115, 19-50-24].pdsprj, Simulation [20230115, 19-52-18].pdsprj, Simulation [20230115, 19-54-19].pdsprj]
2023-01-21 Without sounds on temerature control
    [Simulation [20230115, 19-45-01].pdsprj, Simulation [20230115, 19-45-23].pdsprj, Simulation [20230115, 19-48-05].pdsprj, Simulation [20230115, 19-49-01].pdsprj, Simulation [20230115, 19-49-02].pdsprj, Simulation [20230119, 23-23-44].pdsprj, Simulation [20230121, 13-51-11].pdsprj, Simulation [20230121, 13-51-45].pdsprj]
2023-01-22 Temporary state for +12V Input
2023-01-22 Temporary state for +12V Input v0.2
    [Simulation [20230115, 19-50-24].pdsprj, Simulation [20230122, 16-14-19].pdsprj, Simulation.pdsprj]
2023-01-29 Temperature control v0.2 is OK. Sound must rework
    [Simulation [20230115, 19-52-18].pdsprj, Simulation [20230115, 19-54-19].pdsprj, Simulation [20230115, 21-00-46].pdsprj, Simulation [20230122, 23-11-35].pdsprj, Simulation [20230126, 18-46-11].pdsprj, Simulation [20230126, 19-11-17].pdsprj, Simulation.pdsprj]
2023-01-29 All controls v0.2. Sound must rework.
    [main.c, sounds.c]
2023-01-29 All controls v0.2. Sound must rework. +
    [Simulation [20230119, 19-31-16].pdsprj, Simulation [20230129, 18-15-56].pdsprj, Simulation.pdsprj]
2023-02-02 Sounds + controls is OK. Beta test.
    [Simulation [20230119, 23-23-44].pdsprj, Simulation [20230121, 13-51-11].pdsprj, Simulation [20230202, 18-59-04].pdsprj, Simulation [20230202, 19-55-31].pdsprj, Simulation.pdsprj]
2023-05-01 Sounds is corrected
    [Simulation [20230121, 13-51-45].pdsprj, Simulation [20230121, 13-51-53].pdsprj, Simulation [20230121, 19-49-41].pdsprj, Simulation [20230122, 16-14-19].pdsprj, Simulation [20230122, 23-11-35].pdsprj, Simulation [20230126, 18-46-11].pdsprj, Simulation [20230126, 19-11-17].pdsprj, Simulation [20230501, 13-10-35].pdsprj]
2023-05-01 01052023 between versions commit
    [Configuration.h]
2023-08-03 High Temperature Bug Fix
    [Simulation [20230129, 18-15-56].pdsprj, Simulation [20230202, 18-59-04].pdsprj, Simulation [20230202, 19-55-31].pdsprj, Simulation [20230803, 19-04-24].pdsprj, Simulation [20230803, 19-35-48].pdsprj, Simulation [20230803, 19-42-09].pdsprj, Simulation.pdsprj]
2023-08-08 3 Sec. delay after init for charge capasitors
2023-08-20 Bugfix 20082023
    [Simulation [20230501, 13-10-35].pdsprj, Simulation [20230501, 13-18-29].pdsprj, Simulation [20230501, 13-20-49].pdsprj, Simulation [20230501, 13-21-42].pdsprj, Simulation [20230501, 13-23-01].pdsprj, Simulation [20230501, 13-24-07].pdsprj, Simulation [20230501, 13-30-00].pdsprj, Simulation [20230803, 19-04-24].pdsprj]
2023-08-20 Bag FIX 20082023 18:15
    [Simulation [20230820, 11-07-30].pdsprj, Simulation [20230820, 11-11-58].pdsprj, Simulation [20230820, 11-52-16].pdsprj, Simulation [20230820, 11-55-01].pdsprj, Simulation [20230820, 11-55-42].pdsprj, Simulation [20230820, 11-57-06].pdsprj, Simulation [20230820, 11-57-15].pdsprj, Simulation [20230820, 17-31-00].pdsprj]
2023-08-20 Bug FIX 20082023 18:40
    [Simulation [20230820, 11-58-29].pdsprj, Simulation [20230820, 11-59-53].pdsprj, Simulation [20230820, 18-22-18].pdsprj, Simulation [20230820, 18-38-16].pdsprj, Simulation.pdsprj]
2023-08-27 Delay 2.5 sec after Voltage normalisation
    [Simulation [20230820, 12-02-16].pdsprj, Simulation [20230820, 17-31-00].pdsprj, Simulation [20230820, 17-31-01].pdsprj, Simulation [20230820, 17-33-14].pdsprj, Simulation [20230820, 17-33-38].pdsprj, Simulation [20230820, 18-09-41].pdsprj, Simulation [20230820, 18-10-50].pdsprj, Simulation [20230820, 18-13-26].pdsprj]
2023-08-27 Temporary state to fix Voltage control bag
    [Simulation [20230827, 09-41-10].pdsprj, Simulation [20230827, 16-36-16].pdsprj, Simulation.pdsprj]
2023-08-27 14.2-14.5V good Battery
    [Simulation [20230827, 09-47-09].pdsprj, Simulation [20230827, 18-23-27].pdsprj, Simulation.pdsprj]
2023-08-27 27082023 final i think
    [Simulation [20230827, 09-47-26].pdsprj, Simulation [20230827, 09-48-33].pdsprj, Simulation [20230827, 09-48-54].pdsprj, Simulation [20230827, 19-34-17].pdsprj, Simulation [20230827, 19-34-55].pdsprj, Simulation [20230827, 19-49-59].pdsprj, Simulation.pdsprj]
2023-09-23 Reset problem
    [Simulation [20230827, 10-21-28].pdsprj, Simulation [20230827, 10-23-26].pdsprj, Simulation [20230827, 20-27-56].pdsprj, Simulation [20230827, 20-30-54].pdsprj, Simulation.pdsprj]
2023-09-24 24092023 between state
    [Simulation [20230827, 10-23-58].pdsprj, Simulation [20230827, 10-24-54].pdsprj, Simulation [20230827, 10-36-48].pdsprj, Simulation [20230827, 16-36-16].pdsprj, Simulation [20230924, 17-43-09].pdsprj, Simulation [20230924, 17-43-10].pdsprj, Simulation [20230924, 17-43-44].pdsprj, Simulation [20230924, 17-49-23].pdsprj]
2023-09-24 24092023 Zurück
    [Simulation [20230827, 18-23-27].pdsprj, Simulation [20230827, 19-34-17].pdsprj, Simulation [20230827, 19-34-55].pdsprj, Simulation [20230827, 19-49-59].pdsprj, Simulation [20230924, 20-09-59].pdsprj, Simulation [20230924, 20-11-53].pdsprj, Simulation [20230924, 20-12-57].pdsprj, Simulation [20230924, 20-15-23].pdsprj]
2023-10-01 Voltage Limits bug fix
2023-10-04 Global values is 0 in init
    [Simulation [20230827, 20-27-56].pdsprj, Simulation [20231004, 21-03-15].pdsprj, Simulation.pdsprj]
2023-11-11 new changes on R00
    [Simulation R01 [20231108, 21-07-55].pdsprj, Simulation R01 [20231108, 21-09-41].pdsprj, Simulation R01 [20231108, 21-11-17].pdsprj, Simulation R01 [20231108, 21-12-00].pdsprj, Simulation R01 [20231108, 21-12-14].pdsprj, Simulation R01 [20231108, 21-14-46].pdsprj, Simulation R01 [20231108, 21-15-12].pdsprj, Simulation R01 [20231108, 21-15-13].pdsprj]
2023-11-12 new changes in R00
    [Simulation [20230827, 20-30-54].pdsprj, Simulation [20230924, 17-43-09].pdsprj, Simulation [20230924, 17-49-23].pdsprj, Simulation [20230924, 20-09-59].pdsprj, Simulation [20230924, 20-11-53].pdsprj, Simulation [20230924, 20-12-57].pdsprj, Simulation [20230924, 20-15-23].pdsprj, Simulation [20231004, 21-03-15].pdsprj]
2023-11-12 after simulation R00
    [Simulation [20230924, 17-43-10].pdsprj, Simulation [20230924, 17-43-44].pdsprj, Simulation [20231111, 20-18-08].pdsprj, Simulation [20231111, 20-18-14].pdsprj, Simulation [20231111, 20-20-46].pdsprj, Simulation [20231111, 20-20-52].pdsprj, Simulation [20231111, 20-20-53].pdsprj, Simulation [20231111, 20-20-54].pdsprj]
2023-11-30 Voltage control with ISR
    [Simulation [20231112, 19-40-50].pdsprj, Simulation [20231112, 19-41-12].pdsprj, Simulation [20231112, 19-41-27].pdsprj, Simulation [20231112, 19-41-48].pdsprj, Simulation [20231112, 19-42-26].pdsprj, Simulation [20231112, 19-42-38].pdsprj, Simulation [20231112, 19-43-16].pdsprj, Simulation [20231112, 19-43-25].pdsprj]
2023-12-06 ADC measure in main
    [Simulation [20231129, 22-07-26].pdsprj, Simulation [20231129, 22-15-39].pdsprj, Simulation [20231129, 22-18-24].pdsprj, Simulation [20231129, 22-19-23].pdsprj, Simulation [20231129, 22-19-30].pdsprj, Simulation [20231129, 22-21-47].pdsprj, Simulation [20231129, 22-24-24].pdsprj, Simulation [20231130, 17-36-41].pdsprj]
2024-02-14 Between state. Simulation is good. Need to fix alarms, when is errors on both measure types.
    [Simulation [20231206, 17-46-08].pdsprj, Simulation [20231206, 17-46-36].pdsprj, Simulation [20231206, 17-46-56].pdsprj, Simulation [20231206, 17-47-15].pdsprj, Simulation [20231206, 17-47-40].pdsprj, Simulation [20231206, 17-49-51].pdsprj, Simulation [20231206, 17-55-57].pdsprj, Simulation [20231206, 17-56-11].pdsprj]
2024-02-22 Two Warnings
    [Simulation [20240214, 21-14-56].pdsprj, Simulation [20240214, 21-16-19].pdsprj, Simulation [20240214, 21-18-15].pdsprj, Simulation [20240214, 21-21-04].pdsprj, Simulation [20240214, 21-22-22].pdsprj, Simulation [20240214, 21-25-21].pdsprj, Simulation [20240214, 21-26-35].pdsprj, Simulation [20240214, 21-27-57].pdsprj]
2024-02-22 Bad sound. Interrupts ok.
2024-03-02 02032024 v2
    [Simulation [20240219, 20-49-47].pdsprj, Simulation [20240219, 20-50-25].pdsprj, Simulation [20240219, 20-53-13].pdsprj, Simulation [20240219, 20-55-50].pdsprj, Simulation [20240219, 20-56-20].pdsprj, Simulation [20240219, 20-57-01].pdsprj, Simulation [20240302, 21-04-34].pdsprj, Simulation [20240302, 21-04-52].pdsprj]
2024-03-18 Blocker Sound 18032024
    [Simulation [20240317, 21-36-47].pdsprj, Simulation [20240317, 21-37-43].pdsprj, Simulation [20240317, 21-38-11].pdsprj, Simulation [20240317, 21-38-23].pdsprj, Simulation [20240317, 21-38-49].pdsprj, Simulation [20240317, 21-43-37].pdsprj, Simulation [20240317, 21-46-37].pdsprj, Simulation [20240317, 21-46-41].pdsprj]
2024-03-21 21032024 8bit measure
    [Simulation [20240318, 19-43-10].pdsprj, Simulation [20240318, 20-00-05].pdsprj, Simulation [20240318, 20-02-06].pdsprj, Simulation [20240318, 20-02-24].pdsprj, Simulation [20240318, 20-02-51].pdsprj, Simulation [20240318, 20-03-15].pdsprj, Simulation [20240318, 20-05-28].pdsprj, Simulation [20240318, 20-29-47].pdsprj]
2024-03-27 Sound and simulation is OK
    [Simulation [20240321, 20-16-07].pdsprj, Simulation [20240321, 20-16-43].pdsprj, Simulation [20240321, 20-17-03].pdsprj, Simulation [20240321, 20-17-21].pdsprj, Simulation [20240321, 20-17-40].pdsprj, Simulation [20240321, 20-18-12].pdsprj, Simulation [20240321, 20-22-11].pdsprj, Simulation [20240321, 20-22-49].pdsprj]
2024-03-29 Simulation OK, uC in Error
    [Simulation [20240327, 20-43-48].pdsprj, Simulation [20240327, 20-55-24].pdsprj, Simulation [20240329, 13-45-50].pdsprj, Simulation [20240329, 13-59-11].pdsprj, Simulation.pdsprj]
2024-03-29 adcValue is back
    [Simulation [20240327, 20-56-42].pdsprj, Simulation [20240327, 20-57-14].pdsprj, Simulation [20240327, 20-58-17].pdsprj, Simulation [20240327, 20-59-10].pdsprj, Simulation [20240327, 21-02-06].pdsprj, Simulation [20240327, 21-13-27].pdsprj, Simulation [20240327, 21-15-04].pdsprj, Simulation [20240327, 21-15-44].pdsprj]
2024-03-29 ADC defect
    [Simulation [20240329, 13-59-11].pdsprj, Simulation [20240329, 20-18-00].pdsprj, Simulation [20240329, 20-22-19].pdsprj, Simulation [20240329, 20-23-18].pdsprj, Simulation [20240329, 20-23-33].pdsprj, Simulation [20240329, 20-24-15].pdsprj, Simulation [20240329, 20-24-37].pdsprj, Simulation [20240329, 20-25-03].pdsprj]
2024-06-02 Checked with real HW Prototype R0.01
    [Simulation [20240329, 20-31-54].pdsprj, Simulation [20240329, 21-10-52].pdsprj, Simulation [20240329, 21-11-07].pdsprj, Simulation [20240329, 21-11-33].pdsprj, Simulation [20240329, 21-15-19].pdsprj, Simulation [20240331, 18-51-32].pdsprj, Simulation [20240407, 15-17-33].pdsprj, Simulation [20240407, 15-18-07].pdsprj]
2024-06-02 Checked with real HW Prototype R0.01 v1
2024-08-25 works on my HW Prototype
    [BusSwitch [20240616, 17-19-15].pdsprj, BusSwitch.pdsprj, Measurmnets25082024.xlsx, Simulation_Coop [20240825, 12-07-45].pdsprj, Simulation_Coop [20240825, 12-08-35].pdsprj, Simulation_Coop [20240825, 12-08-58].pdsprj, Simulation_Coop [20240825, 12-09-25].pdsprj, Simulation_Coop [20240825, 12-09-45].pdsprj]
2024-08-25 Same adc measurement values of Prototype V.1 and real HW
2024-08-25 To good start added 2.5s to capacitors load
2024-08-25 Check for 2.5s capacitors load
2024-08-25 load after pwm off
2024-08-25 load after pwm off v2
2024-08-26 26082024 v1
    [Measurmnets25082024.xlsx]
2024-08-29 29082024 v1
    [Simulation_Coop [20240825, 12-07-45].pdsprj, Simulation_Coop [20240825, 12-08-35].pdsprj, Simulation_Coop [20240825, 12-08-58].pdsprj, Simulation_Coop [20240825, 12-09-25].pdsprj, Simulation_Coop [20240825, 12-09-45].pdsprj, Simulation_Coop [20240825, 12-11-52].pdsprj, Simulation_Coop [20240825, 12-12-09].pdsprj, Simulation_Coop [20240825, 12-12-53].pdsprj]
2024-09-02 02092024 v1
    [Simulation_Coop [20240828, 20-57-59].pdsprj, Simulation_Coop [20240828, 20-59-32].pdsprj, Simulation_Coop [20240828, 21-01-14].pdsprj, Simulation_Coop [20240828, 21-07-33].pdsprj, Simulation_Coop [20240828, 21-08-54].pdsprj, Simulation_Coop [20240828, 21-10-01].pdsprj, Simulation_Coop [20240828, 21-10-29].pdsprj, Simulation_Coop [20240828, 21-11-38].pdsprj]
2024-09-03 03092024 v1
    [Simulation_Coop [20240828, 21-18-49].pdsprj, Simulation_Coop [20240902, 19-30-40].pdsprj, Simulation_Coop [20240902, 19-32-31].pdsprj, Simulation_Coop [20240903, 20-09-52].pdsprj, Simulation_Coop [20240903, 20-10-41].pdsprj, Simulation_Coop [20240903, 20-11-25].pdsprj, Simulation_Coop.pdsprj]
2024-09-09 09092024 Median filtration
    [Simulation_Coop [20240902, 19-32-55].pdsprj, Simulation_Coop [20240902, 20-11-27].pdsprj, Simulation_Coop [20240902, 20-15-40].pdsprj, Simulation_Coop [20240902, 20-16-35].pdsprj, Simulation_Coop [20240902, 20-17-15].pdsprj, Simulation_Coop [20240902, 20-17-40].pdsprj, Simulation_Coop [20240902, 20-19-22].pdsprj, Simulation_Coop [20240903, 20-09-52].pdsprj]
2024-11-02 Added emulator/filter schematic project
    [Filter.SchDoc, PIC12F675_prt.PcbLib, PIC12F675_prt.PrjPcb, PIC12F675_prt.SCHLIB, PIC12F675_prt.xlsx, ProtoGrids.PcbLib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]
2025-02-10 10022025 Rev1.2
    [Filter.SchDoc, PIC12F675_V2_prt.xlsx, power.SchDoc, uCCtrl.SchDoc]
2025-04-30 must using passive filter
    [Filter.SchDoc, Filter_Simulation [20250426, 20-35-37].pdsprj, Filter_Simulation [20250426, 20-41-18].pdsprj, Filter_Simulation [20250426, 21-14-49].pdsprj, Filter_Simulation [20250427, 21-44-36].pdsprj, Filter_Simulation.pdsprj, PIC12F675_V2_prt.xlsx, PIC12F675_prt.PcbLib]
2025-07-18 Schematic project V3
    [Emulator.GBL, Emulator.GBO, Emulator.GBP, Emulator.GBS, Emulator.GKO, Emulator.GM1, Emulator.GTL, Emulator.GTO]
2025-09-03 V0.1 All works. Non Blocking sound. PIC12F675. Only blocking pause before ADC start.
    [Config_1.txt, Config_2.txt, Filter.SchDoc, Measurmnets25082024.xlsx, Simulation [20240329, 21-20-31].pdsprj, Simulation [20240329, 21-20-52].pdsprj, Simulation [20240329, 21-21-30].pdsprj, Simulation [20240329, 21-22-19].pdsprj]
2025-09-16 Little changes 16.09.2025
    [Config_1.txt, Config_2.txt, Configuration.h, uCCtrl.SchDoc]
2025-09-21 21092025 Fehler mit transistoren
    [uCCtrl.SchDoc]
